danilodsp/xBee_project/doc/photos_and_diagrams/DSC00005.JPG

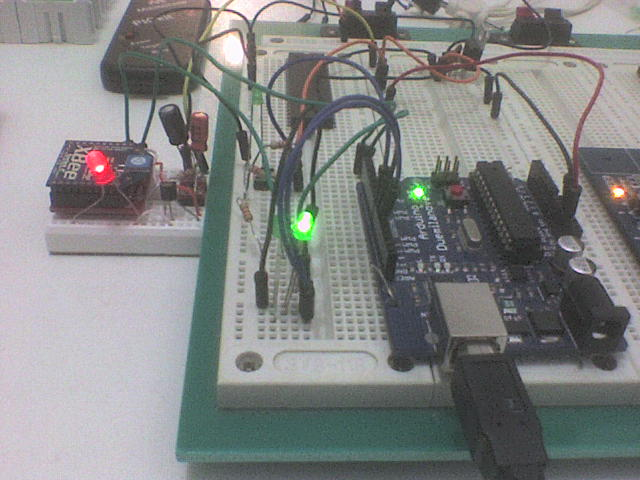
doc/photos_and_diagrams/DSC00005.JPG
