danilodsp/xBee_project/doc/photos_and_diagrams/DSC00004.JPG

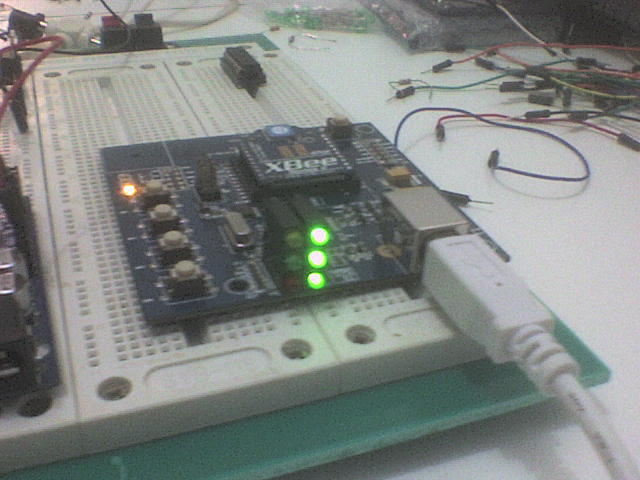
doc/photos_and_diagrams/DSC00004.JPG
