danilodsp/xBee_project/README.md

# Project xBee (2011)

This project is a solution for sensing and actuating using electronic devices to create a smart environment.

## Directories

- code/

- doc/

## Authors

Danilo Pena

Marcelo Besch
