danilodsp/xBee_project/code/firmware/readme.txt

	frame[0] = 0x7E; //7E
	frame[1] = 0x00; //00
	frame[2] = 0x04; //04
	frame[3] = 0x08; //08
	frame[4] = 0x52; //52
	frame[5] = 0x4E; //4E
	frame[6] = 0x4A; //4A
	frame[7] = 0x0D; //0D

TEMP:7E 00 12 92 00 13 A2 00 40 3C 88 DC 2B 3E 41 01 00 00 01 01 E3 48
#7E#00#12#92#00#13#A2#00#40#3C#88#DC#2B#3E#41#01#00#00#01#01#E3#48
// prática
TEMP:0x16 0x7E 0x00 0x12 0x92 0x00 0x13 0xA2 0x00 0x40 0x3C 0x88 0xDC 0xEF 0x1F 0x41 0x01 0x00 0x00 0x01 0x01 0xF1 0x95 

----

1:7E 00 04 08 52 4E 4A 0D
2:7E 00 06 88 52 4E 4A 00 FF 8E

// prática
1:7E 00 04 08 52 4E 4A 0D
2:7E 00 06 52 8E

1:7E 00 04 08 52 4E 4A 0D
2:0x7E 0x00 0x06 0x88 0x52 0x4E 0x4A 0x00 0xFF 0x8E 
2:0x0A 0x7E 0x00 0x06 0x88 0x52 0x4E 0x4A 0x00 0xFF 0x8E 
2:0x02 0x7E 0x00 0x06 0x88 0x52 0x4E 0x4A 0x00 0x01 0x00 
2:0x02 0x7E 0x00 0x06 0x88 0x52 0x4E 0x4A 0x00 0x01 0x20 
2:0x02 0x7E 0x00 0x06 0x88 0x52 0x4E 0x4A 0x00 0x01 0x00 
2:0x00 0x02 0x04 0x06 0x08 0x0A 0x0C 0x0E 0x10 0x12 0x14 

0x0A 0x7E 0x00 0x06 0x88 0x52 0x4E 0x4A 0x00 0xFF 0x8E
