danilodsp/xBee_project/doc/presentation.pdf

Danilo de Santana Pena
Marcelo Siqueira Besch

Danilo de Santana Pena
Marcelo Siqueira Besch

## Aplicação de Xbees em Automação

# Sumário Sumário

- Introdução
- Arquitetura
- Descrição
- Microcontrolador
- Aplicações
- Descrição
- Ambiente de
Desenvolvimento
- Microcontrolador
- Descrição
- Configuração
- Periféricos
- Sensores
- Conclusões
- Referências

# Introdução Introdução

O | projeto | possui | aplicações | que | realizam
receptividades e ações através de sensores e atuadores, utilizam uma interface de comunicação RF e executam o gerenciamento e armazenamento de dados com um microcontrolador.


Esquemático

# Arquitetura Arquitetura

## - Descrição

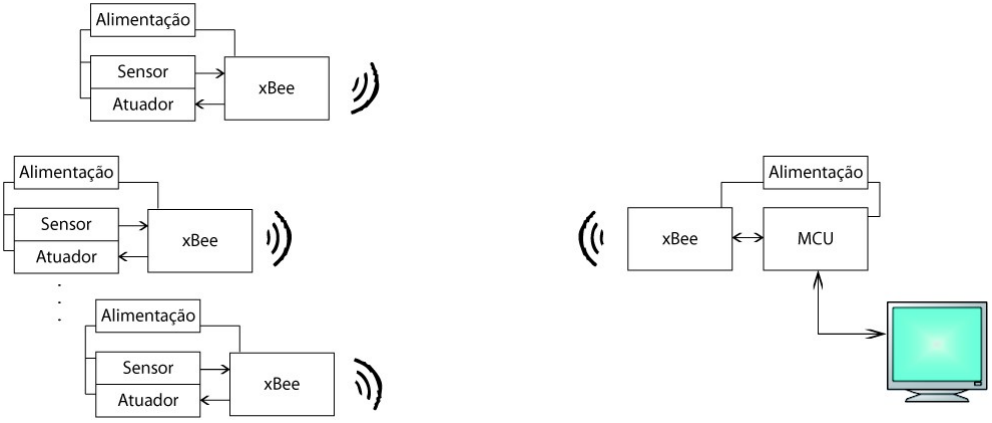
[picture p23: figure]

# Arquitetura Arquitetura

## - Descrição

- Aplicações
– É realizado monitoramento com sensores e ações com atuadores, conectados ao XBee que transmite via RF por um período de amostragem pré-configurado.
- Módulo Base
– Dados recebidos através de um XBee coordenador, trata os dados utilizados, visto o protocolo utilizado e armazena em uma memória para posterior consulta.
– O módulo consiste de um XBee coordenador, um microcontrolador e de alguns periféricos externos.

# Arquitetura Arquitetura

## - Descrição

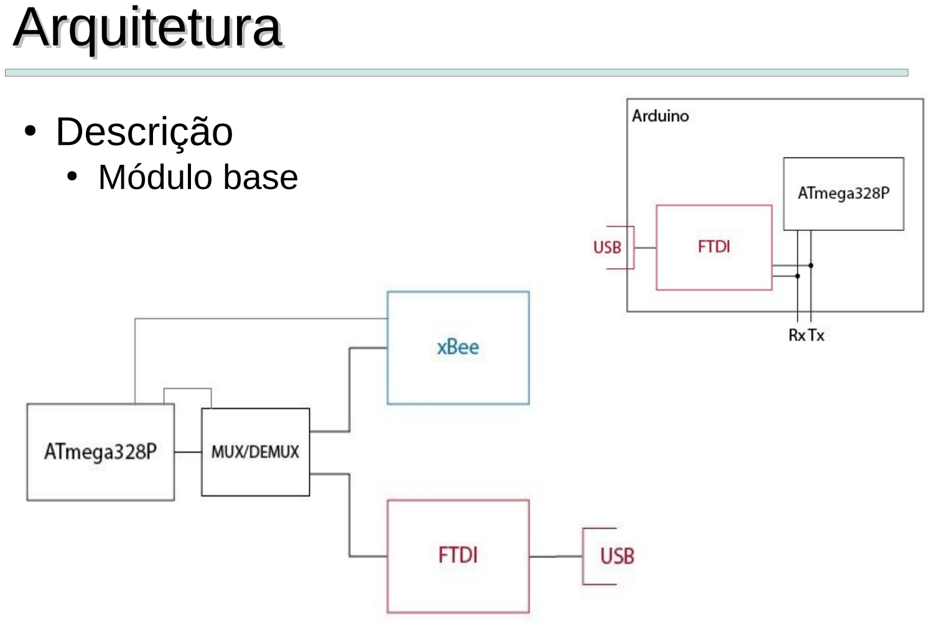
[picture p24: page 6]

- Módulo base

# Arquitetura Arquitetura

## - Descrição

- Módulo base

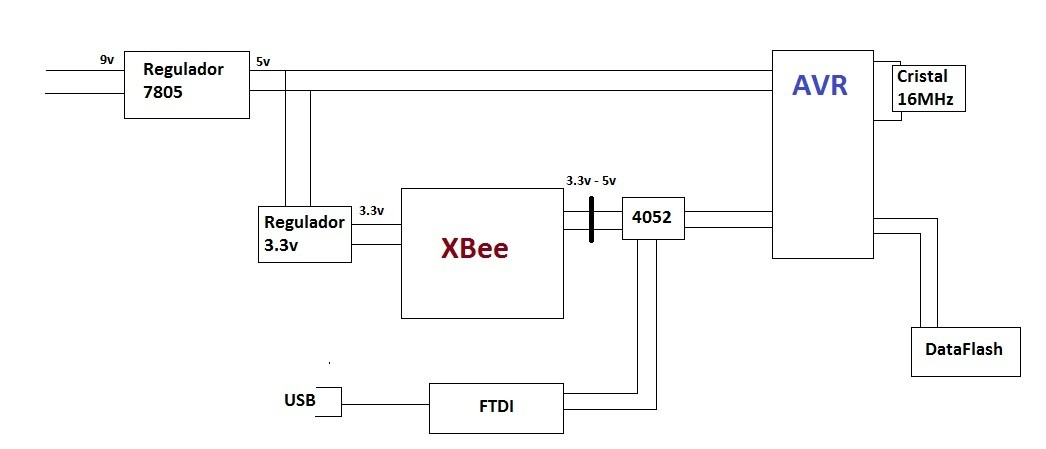
[picture p25: figure]

# Arquitetura Arquitetura

## - Microcontrolador

– São realizadas 3 operações em simultâneo no microcontrolador. Operações de interrupção do TIMER1, que realiza atualizações nos vetores data[3] e hora[3]. Interrupções da UART RX, onde existe uma máquina de estados para tratamento dos bytes recebidos. E por fim interrupções do INT0, que é uma interrupção externa ligada ao pino D2 do microcontrolador, ela possui por função monitorar solicitações de comunicação do computador.
– Possui como interface externa, pinos RX e TX de comunicação UART, INT0 para interrupção externa e saídas para LED's.

# Arquitetura Arquitetura

## - Microcontrolador

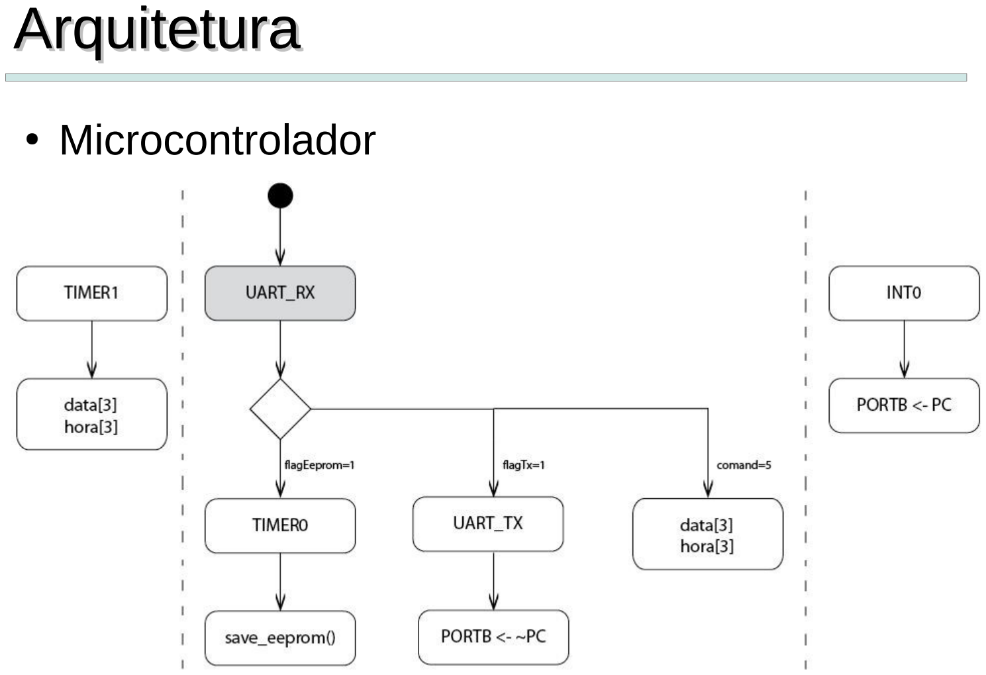
[picture p26: page 9]

# Arquitetura Arquitetura

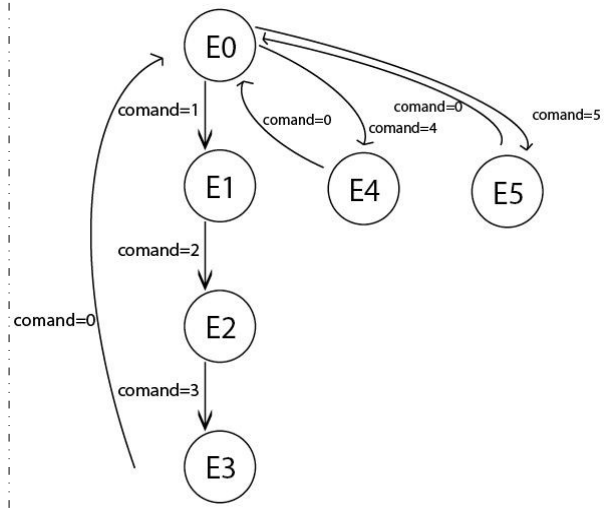
[picture p27: figure]

- Microcontrolador
- E0 – estado inicial
- E1 – Configuração do checksum e tam1.
- E2 – Configuração de tam0 e do frame.
- E3 – Armazenamento de todo o frame e verificação de checksum, da integridade dos dados e se já existe um serial cadastrado na memória. Dispara algumas flag's.
- E4 – Verifica se realmente é o comando requirido. Dispara flag de envio.
- E5 – Faz sincronismo da data e hora recebida do PC com os vetores do uC.

# Aplicações Aplicações

- As aplicações possuem um conjunto de sensores e/ou atuadores, um módulo XBee e componentes de circuito.

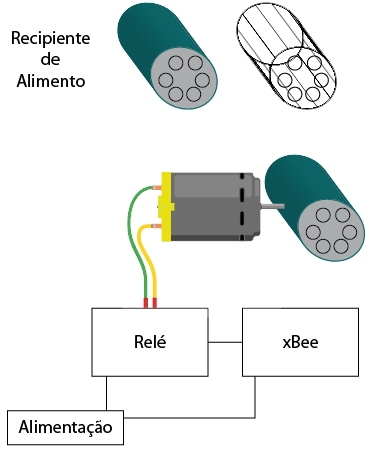
[picture p28: figure]

- Algumas Aplicações:
- Medição de temperatura
- Medição de consumo de
energia elétrica
- Alimentação de peixes
- Segurança em portas
e janelas
- Iluminação externa
- Controle de cortinas

Ex:

# Aplicações Aplicações

## - Medição de temperatura

- Realiza a medição de temperatura através do sensor TMP37.
- Materiais:

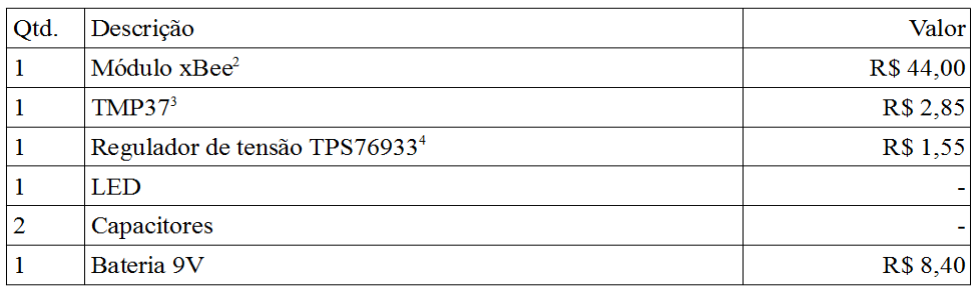
[picture p29: figure]

# Aplicações Aplicações

## - Medição de consumo de energia elétrica

- Realiza a medição de consumo através do sensor ADE7757.

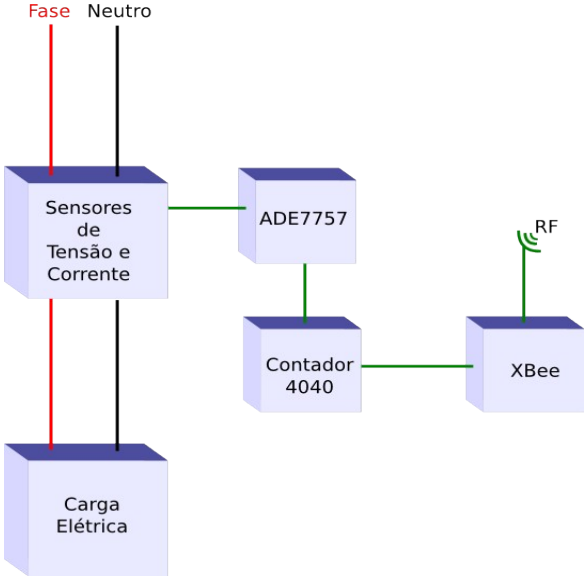
[picture p30: figure]

# Aplicações Aplicações

## - Medição de consumo de energia elétrica

- Materiais:

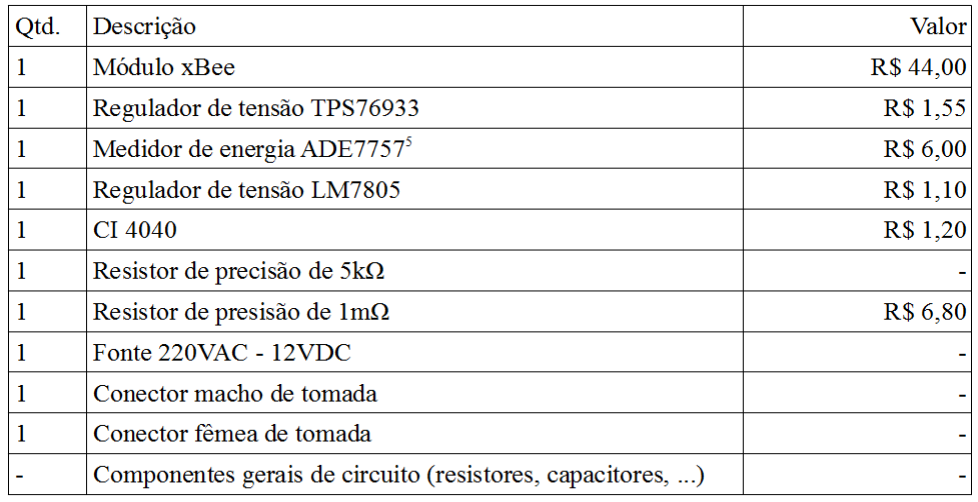
[picture p31: figure]

# Aplicações Aplicações

## - Ambiente de Desenvolvimento

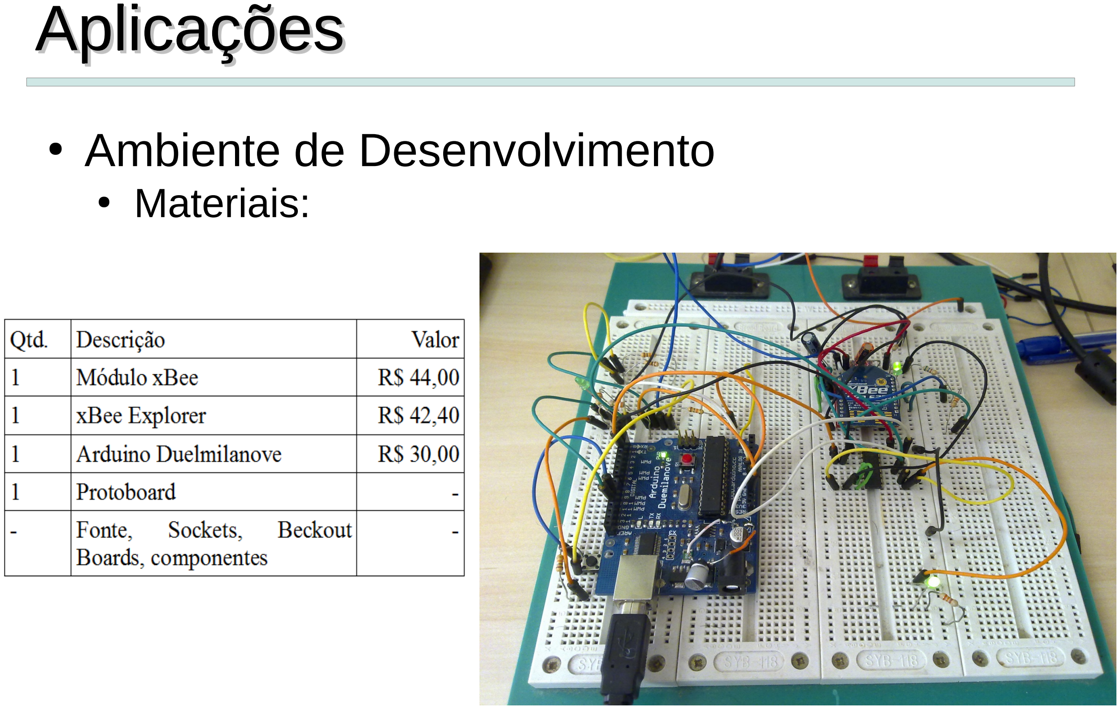
[picture p32: page 15]

- Materiais:

# Microcontrolador Microcontrolador

## - Descrição

- O microcontrolador a ser utilizado é um ATmega328P, da família megaAVR da fabricante Atmel. Trata-se de um micro de 8 bits que apesar de possuir um arquitetura RISC possui um conjunto de 131 instruções. Sua escolha foi baseada em seu rico conjunto de periféricos, possui 32KB de memória flash, 1KB de EEPROM e 2KB de SRAM. Timers de 8 e 16 bits além de comunicação UART e SPI.

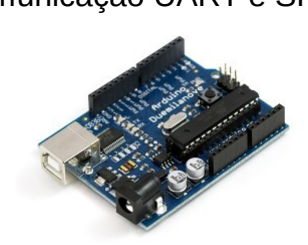
[picture p33: figure]

# Microcontrolador Microcontrolador

## - Configuração

- Para configuração do micro foi necessária a utilização de registros que definem essas configurações. Os detalhes desses registros são
encontrados | na | documentação | do
microcontrolador.

# Microcontrolador Microcontrolador

## - Periféricos

- Timers
– Timer0 é um timer de 8 bits, utilizado para atraso na gravação da EEPROM (30ms), Timer1 é um timer de 16 bits, utilizado para atualização dos vetores data[3] e hora[3].
- EEPROM
– A memória EEPROM do microcontrolador foi utilizada inicialmente para armazenar além dos registros das aplicações também os dados das medições do módulo base. Será utilizado uma memória DataFlash de 16 megabits para armazenamento destes dados.

# Microcontrolador Microcontrolador

## - Periféricos

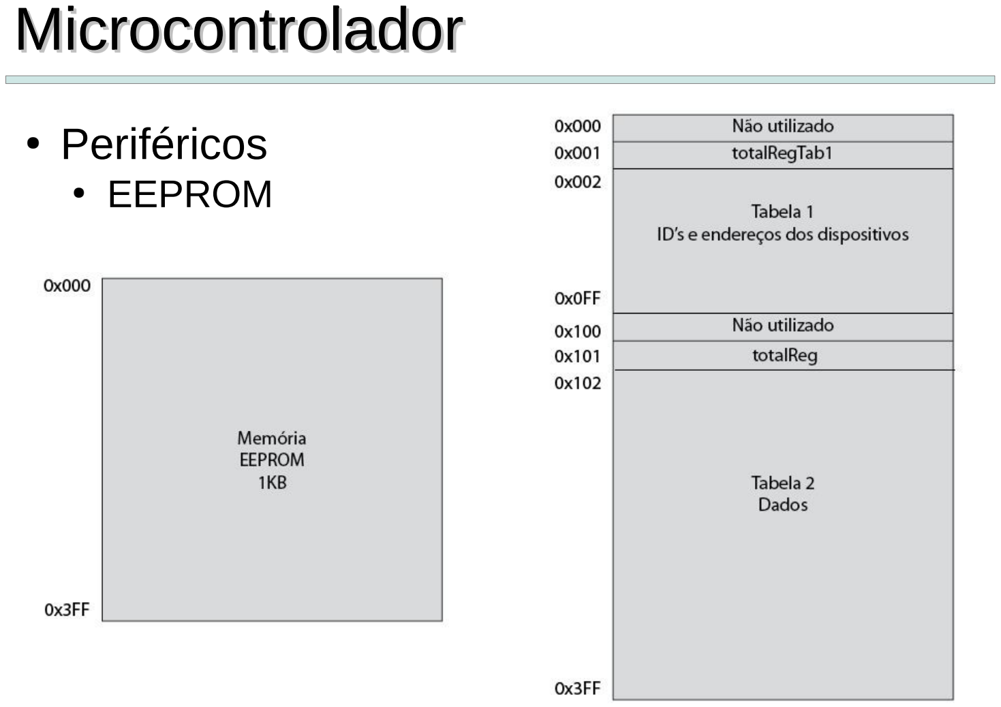
[picture p34: page 19]

- EEPROM

# Microcontrolador Microcontrolador

## - Periféricos

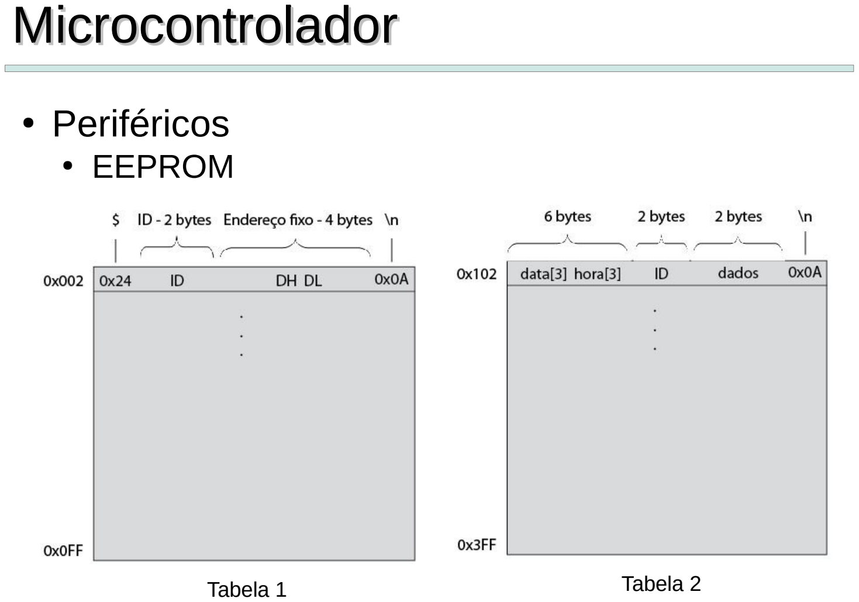
[picture p35: page 20]

- EEPROM
Tabela 1 | Tabela 2

# Sensores Sensores

## - Temperatura

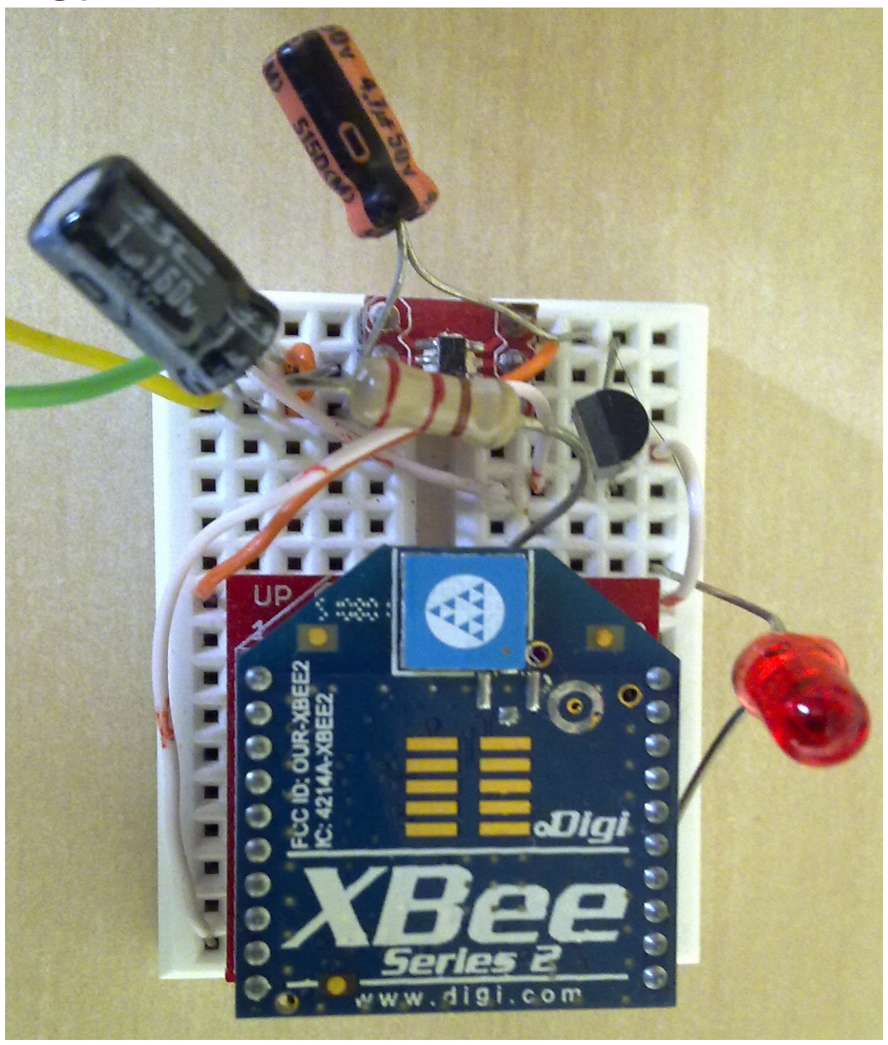
[picture p36: figure]

# Sensores Sensores

## - Consumo

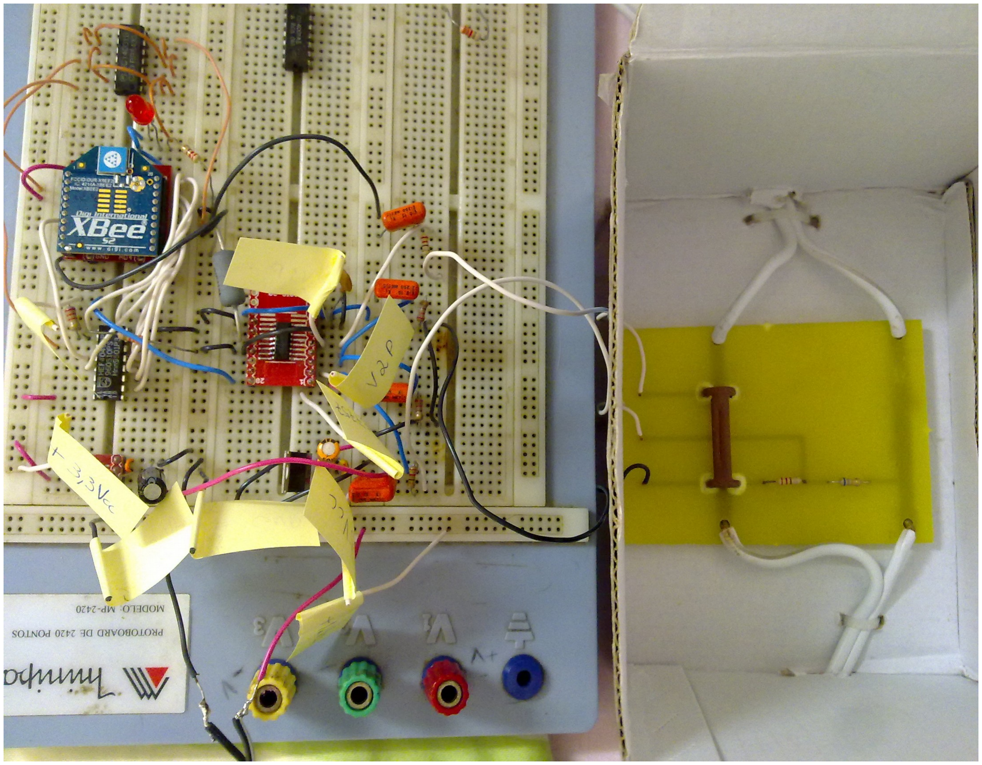
[picture p37: figure]

# Conclusões Conclusões

## - O sistema apresenta funcionamento satisfatório

para um protótipo.

## - Diversos aprimoramentos serão feitos no

próximo mês.

# Referências Referências

[1] - XBee® ZB ZigBee® RF Modules - http://www.digi.com/products/wireless-wired-embedded-solutions/zigbee-rf-modules/zigbee-mesh-module/xbee-zb-module.jsp
[2] - XBee 1mW Chip Antenna - http://www.sparkfun.com/products/8664
[3] - Digikey TMP37FT9Z-ND - http://search.digikey.com/scripts/DkSearch/dksus.dll?Detail&name=TMP37FT9Z-ND
[4] - Digikey TPS76933DBVR - http://search.digikey.com/scripts/DkSearch/dksus.dll?Detail&name=296-11039-1-ND
[5] - Digikey ADE7757ARNZ-ND -http://search.digikey.com/scripts/DkSearch/dksus.dll?Detail&name=ADE7757ARNZ-ND
[6] - Atmel ATmega328P - http://www.atmel.com/dyn/products/product_card.asp?part_id=4198
