danilodsp/xBee_project/doc/schedule/schedule.pdf

UNIVERSIDADE FEDERAL DO RIO GRANDE DO NORTE CENTRO DE TECNOLOGIA
DEPARTAMENTO DE ENGENHARIA ELÉTRICA

Aplicação de xBee's em Automação

Cronograma

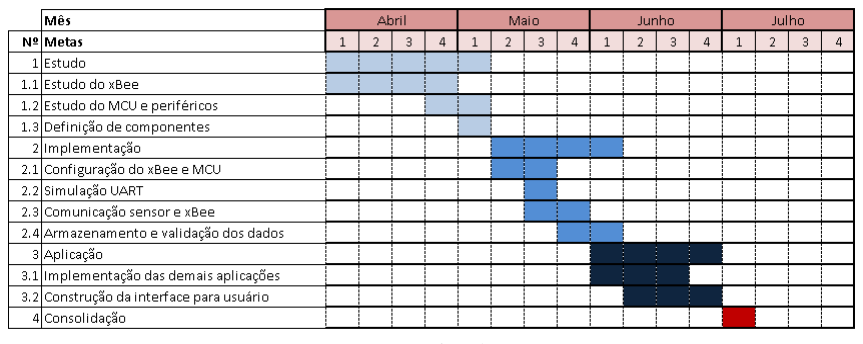
[picture p38: figure]

Descrição:

1. Estudo:
Estudo de comunicação UART, configurações do microcontrolador e configurações do xBee.
2. Implementação:
Configuração do xBee e do microncontrolador, teste com a comunicação entre sensor e xBee além do armazenamento de informações em uma memória.
3. Aplicação:
Implementação com os demais sensores e testes com mais de uma interface do xBee.
4. Consolidação:
Finalização do projeto.

Marcelo Siqueira Besch
Danilo de Santana Pena

Figura 1: Gráfico do cronograma.
