danilodsp/xBee_project/doc/photos_and_diagrams/Arduino and FTDI.JPG

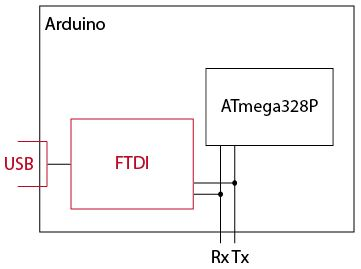
doc/photos_and_diagrams/Arduino and FTDI.JPG
