danilodsp/xBee_project/doc/photos_and_diagrams/diagrama atividades.JPG

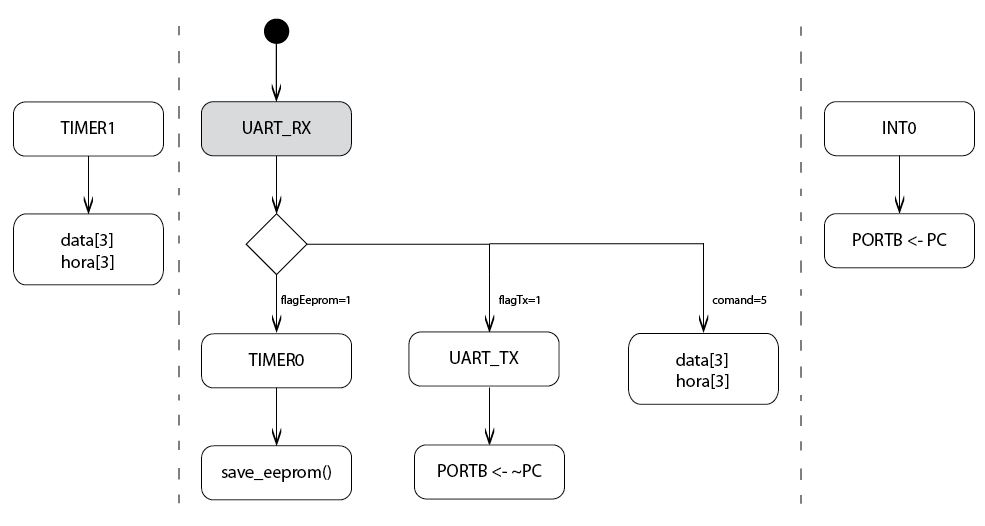
doc/photos_and_diagrams/diagrama atividades.JPG
