danilodsp/xBee_project/doc/photos_and_diagrams/DSC00001.JPG

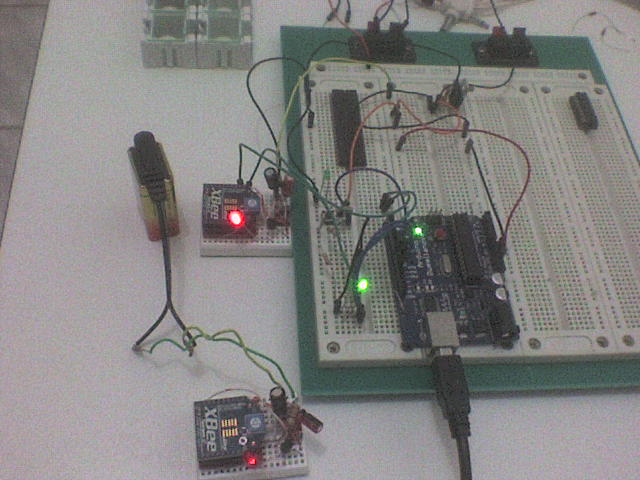
doc/photos_and_diagrams/DSC00001.JPG
