danilodsp/xBee_project/doc/photos_and_diagrams/DSC00003.JPG

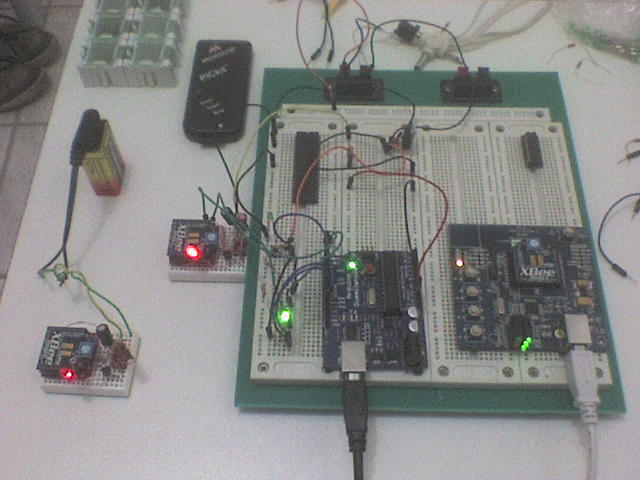
doc/photos_and_diagrams/DSC00003.JPG
