danilodsp/xBee_project/doc/photos_and_diagrams/DSC00006.JPG

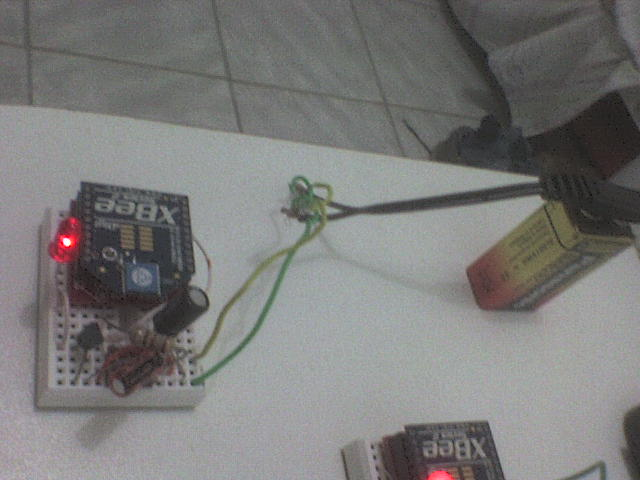
doc/photos_and_diagrams/DSC00006.JPG
