danilodsp/xBee_project/doc/photos_and_diagrams/memoria2.JPG

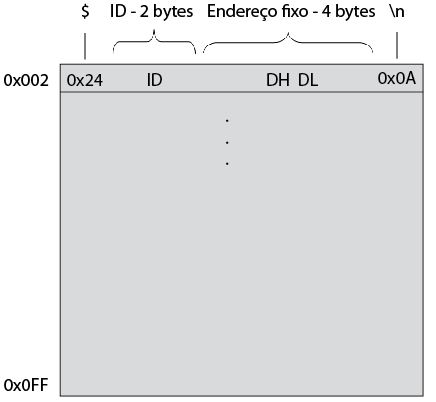
doc/photos_and_diagrams/memoria2.JPG
