danilodsp/xBee_project/doc/photos_and_diagrams/memoria3.JPG

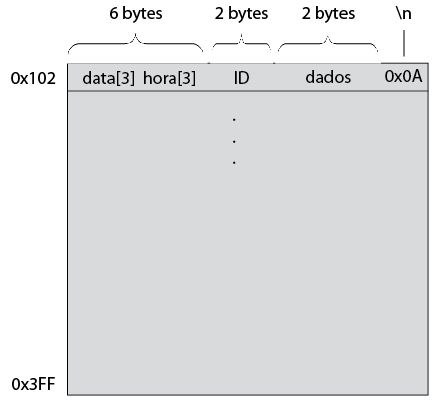
doc/photos_and_diagrams/memoria3.JPG
