danilodsp/xBee_project/doc/photos_and_diagrams/SNC00002.jpg

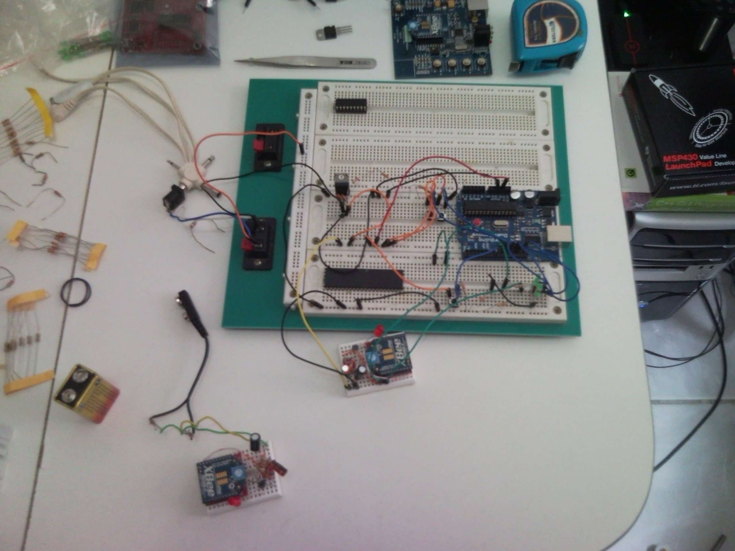
doc/photos_and_diagrams/SNC00002.jpg
