danilodsp/xBee_project/doc/photos_and_diagrams/SNC00010.jpg

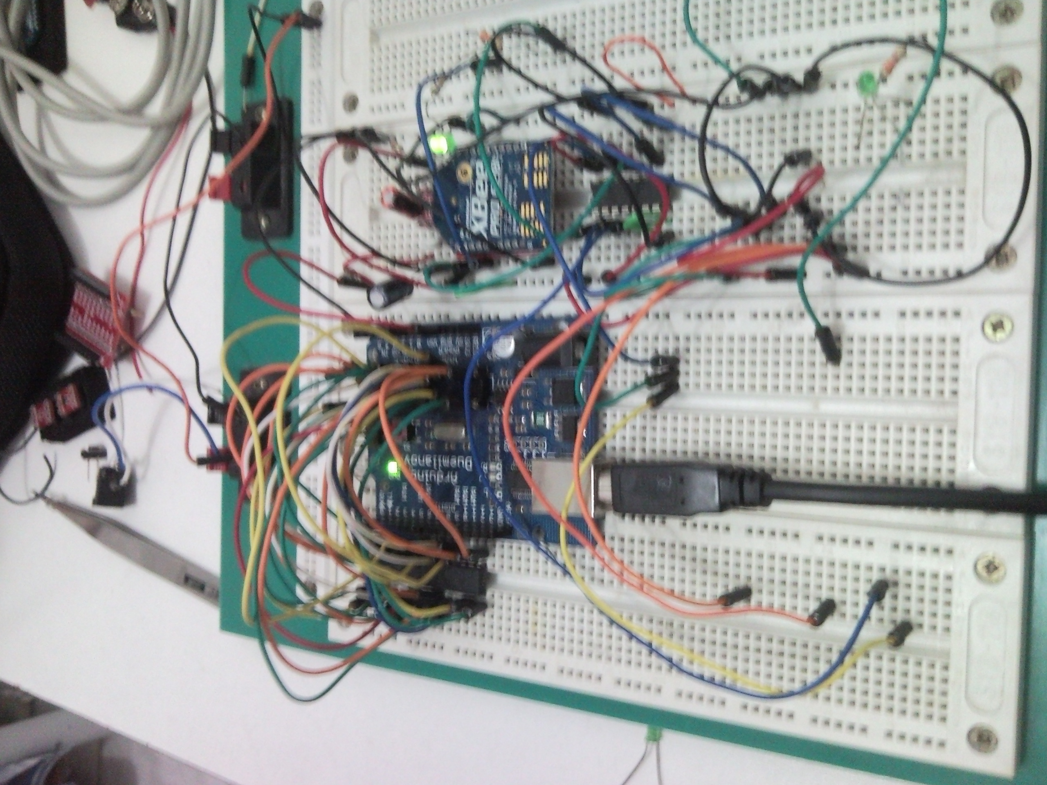
doc/photos_and_diagrams/SNC00010.jpg
