danilodsp/xBee_project/doc/photos_and_diagrams/SNC00013.jpg

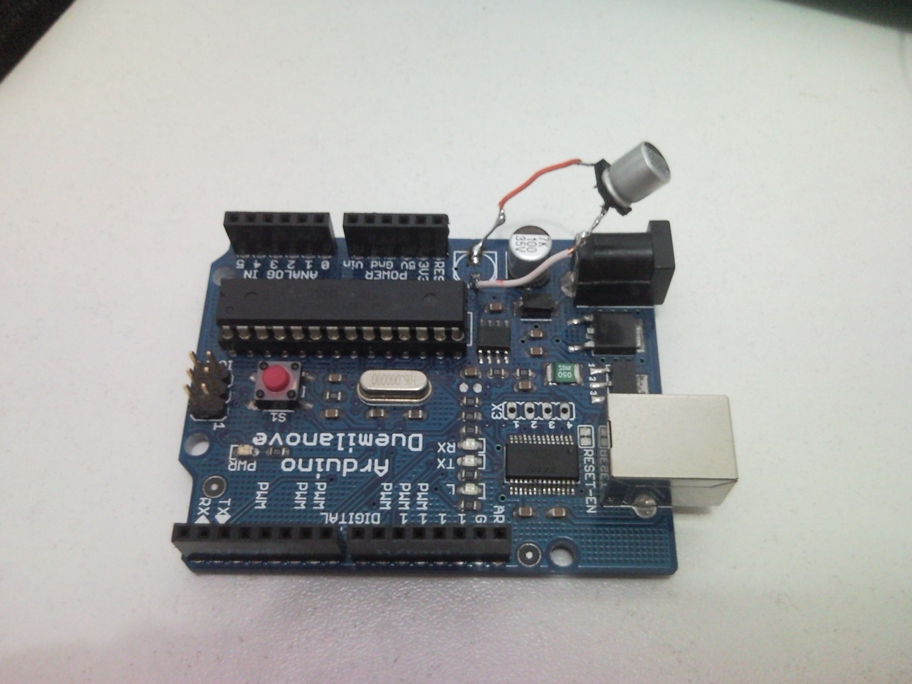
doc/photos_and_diagrams/SNC00013.jpg
