danilodsp/xBee_project/doc/photos_and_diagrams/SNC00014.jpg

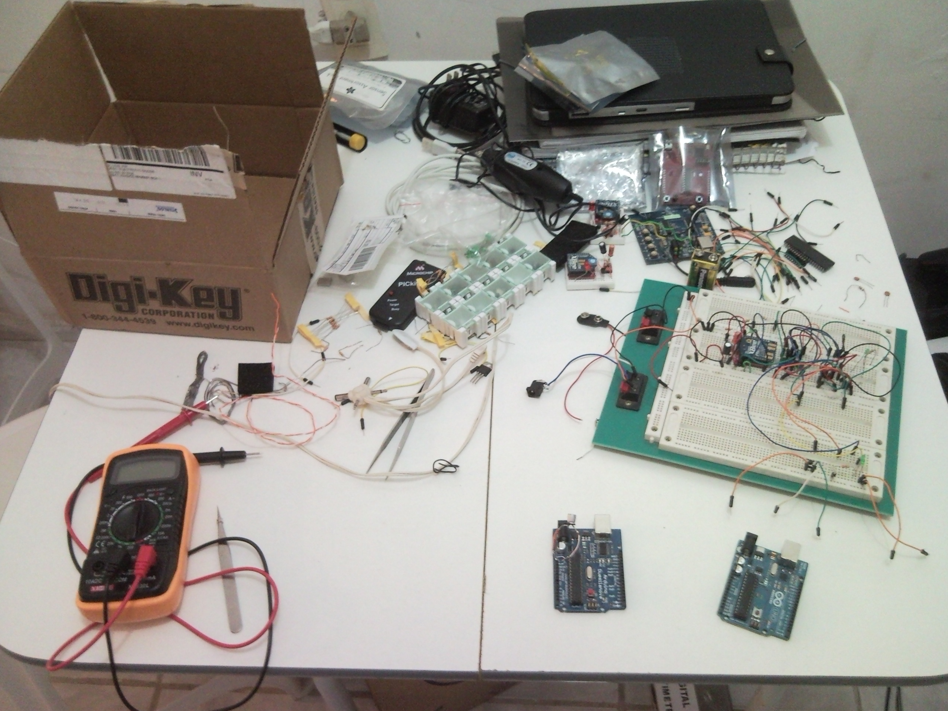
doc/photos_and_diagrams/SNC00014.jpg
