danilodsp/xBee_project/doc/photos_and_diagrams/SNC00015.jpg

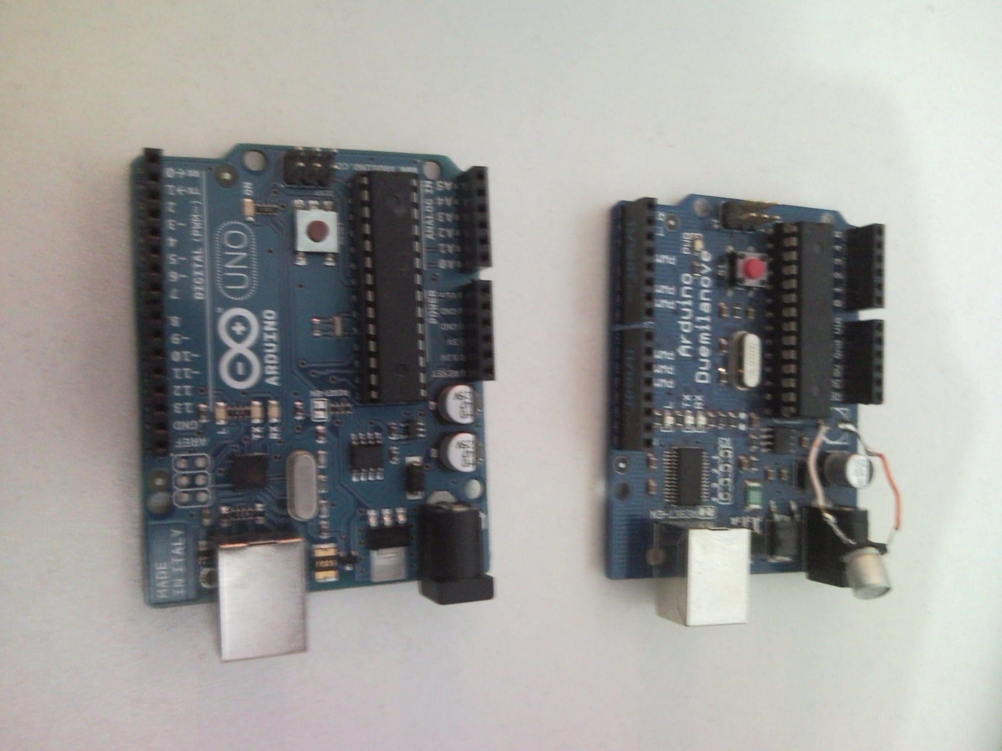
doc/photos_and_diagrams/SNC00015.jpg
