danilodsp/xBee_project/doc/sensors/accelerometer/ADXL33x_MED.jpg

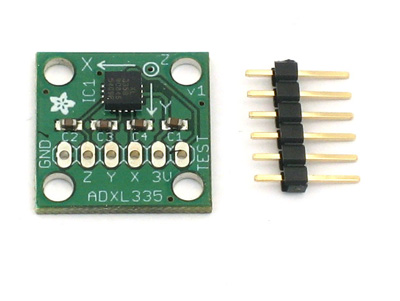
doc/sensors/accelerometer/ADXL33x_MED.jpg
