danilodsp/xBee_project/doc/sensors/accelerometer/ADXL335_fbl.png

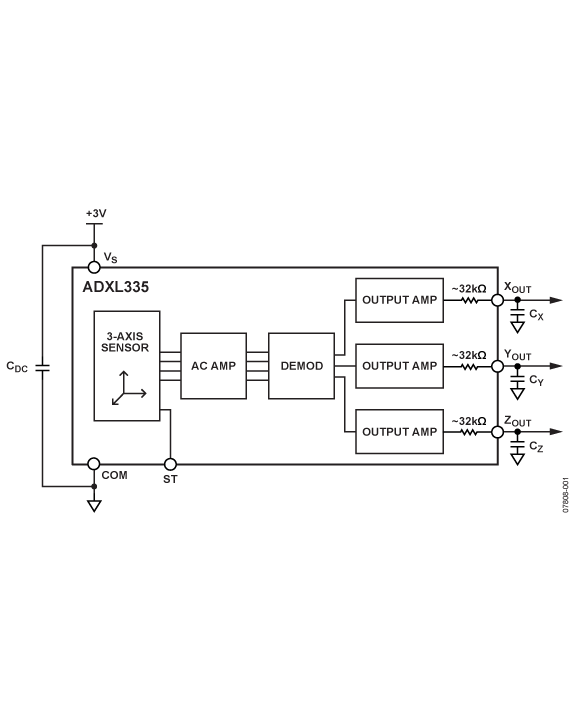
doc/sensors/accelerometer/ADXL335_fbl.png
