danilodsp/xBee_project/doc/sensors/buzzer/buzzer_MED.jpg

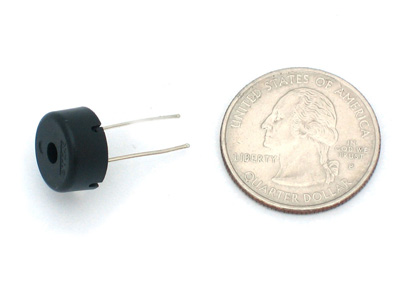
doc/sensors/buzzer/buzzer_MED.jpg
