danilodsp/xBee_project/doc/sensors/hall/halleffect_MED.jpg

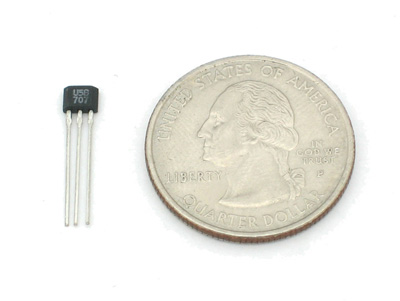
doc/sensors/hall/halleffect_MED.jpg
