danilodsp/xBee_project/doc/sensors/hall/magnet_LRG.jpg

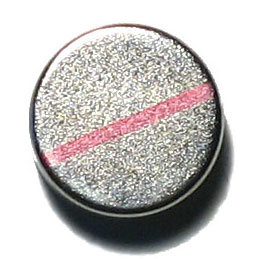
doc/sensors/hall/magnet_LRG.jpg
