danilodsp/xBee_project/doc/sensors/photoresistor/cds_MED.jpg

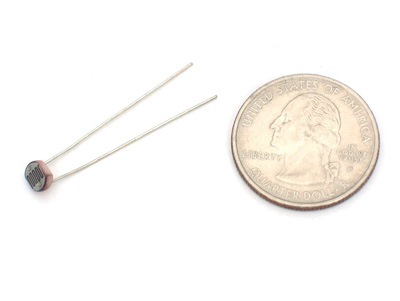
doc/sensors/photoresistor/cds_MED.jpg
