danilodsp/xBee_project/doc/sensors/strength/FSR402_MED.jpg

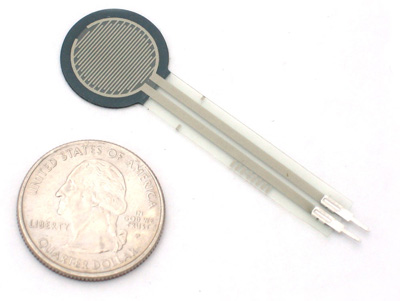
doc/sensors/strength/FSR402_MED.jpg
