danilodsp/xBee_project/doc/sensors/temperature/tmp36graph.gif

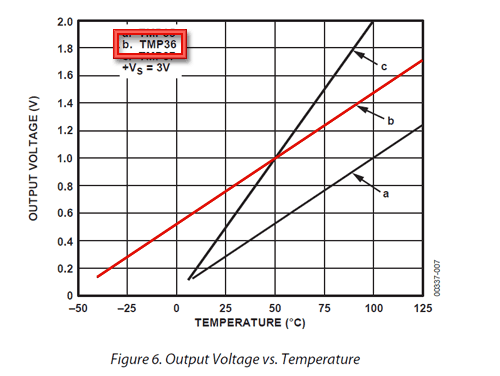
doc/sensors/temperature/tmp36graph.gif
