danilodsp/xBee_project/code/hardware/energ_sensor.pdf

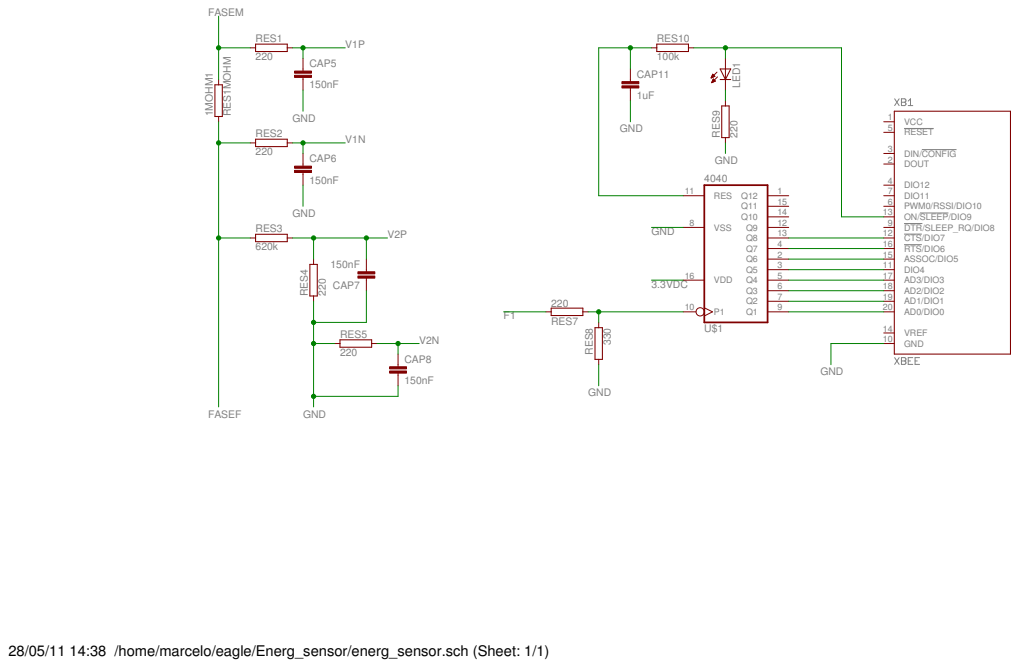
[picture p59: page 1]

28/05/11 14:38 /home/marcelo/eagle/Energ_sensor/energ_sensor.sch (Sheet: 1/1)

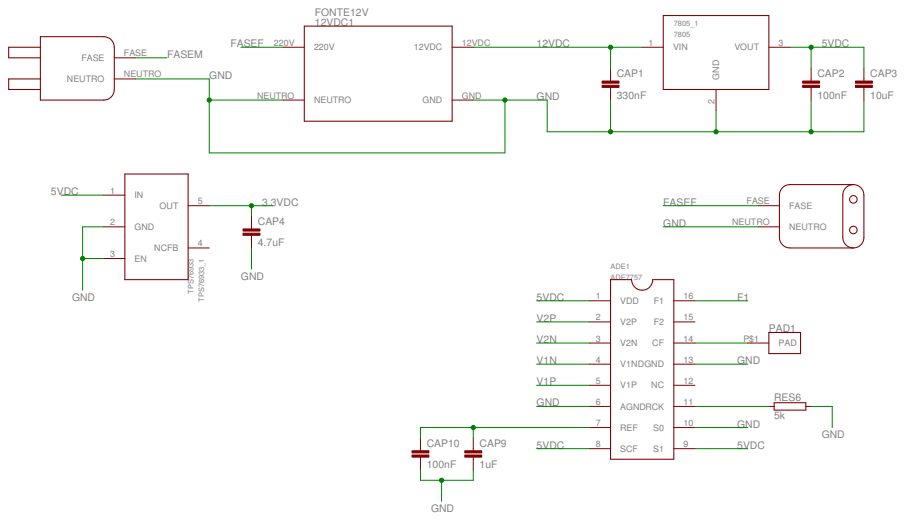
[picture p60: page 2]
