danilodsp/xBee_project/code/testing/Base AVR Proteus/Base.PDF

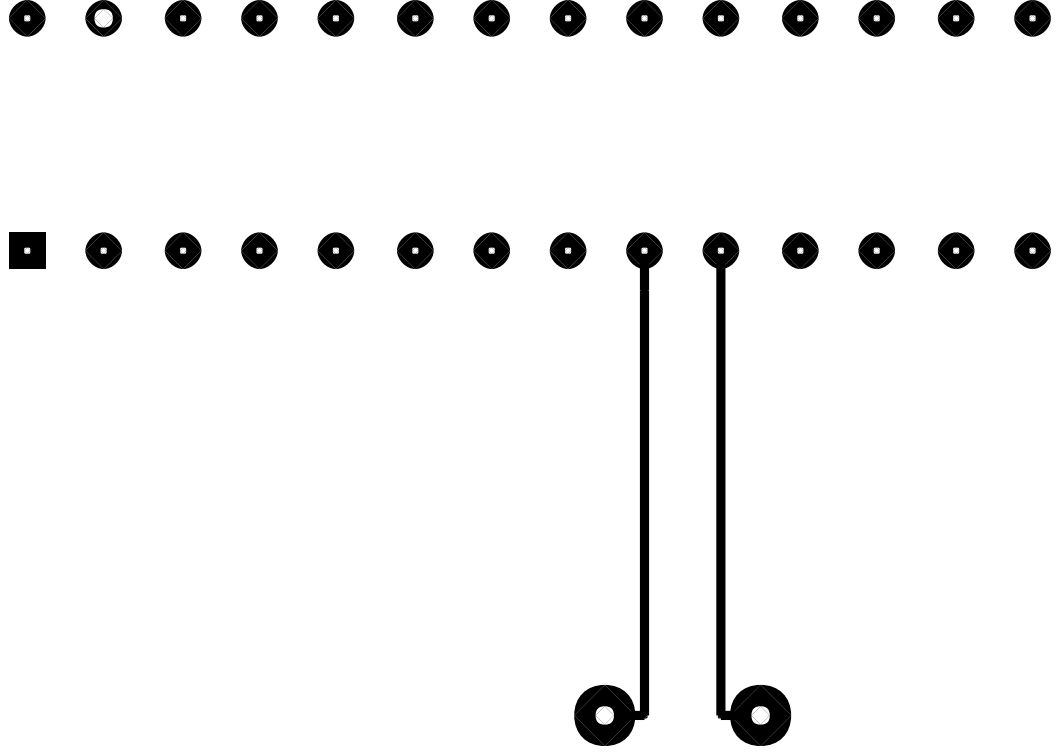
[picture p61: page 1]
