danilodsp/xBee_project/(list of files, drawings)

Other design files:
code/testing/Base AVR Proteus/Base.DSN
code/testing/Proteus/Teste.DSN
