danilodsp/xBee_project/(commit log)

2019-09-08 Add application software
    [energ_sensor.sch, materiais.ods]
2019-09-08 Add schematic using Eagle
2019-09-08 Add library for hardware schematic
2019-09-08 Add uart project
2019-09-08 Add testing using Proteus
    [Base.DSN]
2019-09-08 Update to current version
